1988maciejt/zabezpieczenie_samochodu_przed_kradzieza/Dokumentacja/Sposób podłączenia.pptx

Zasilanie pompy

Pompa paliwa

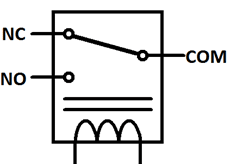
[picture p1: figure]

12V po stacyjce

Przycisk / czujnik dotykowy

Zabezpieczenie

Przekaźnik 12V
