1988maciejt/zabezpieczenie_samochodu_przed_kradzieza/Dokumentacja/Konfiguracja.docx

## Zabezpieczenie samochodu przed kradzieżą – konfiguracja

Wejście w tryb konfiguracji odbywa się następująco:

1. Włączyć zapłon.
2. Wcisnąć i trzymać przycisk odblokowania po upływie 1 sekundy, a przed upływem 2 sekund od włączenia zapłonu.
3. Usłyszymy przeciągły pisk brzęczyka (3 sekundy, ciągły).
4. Od tego momentu co 2 sekundy brzęczyk będzie generował serie odpowiednio 1, 2 lub 3 piknięć. Ka\zda seria odpowiada jednemu z trzech trybów pracy zabezpieczenia. Wybór odpowiedniego trybu dokonywany jest poprzez puszczenie przycisku zaraz po (lub w trakcie) wybrzmieniu odpowiedniej serii piknięć.

Tryby pracy:

1 – praca normalna (zabezpieczenie aktywne)

2 – zabezpieczenie nieaktywne, pompa zawsze uruchomiona (tryb odpowiedni podczas np. odstawienia samochodu do mechanika)

3 – zabezpieczenie nieaktywne, pompa zawsze wyłączona.
