1988maciejt/zabezpieczenie_samochodu_przed_kradzieza/Dokumentacja/Schemat.pdf

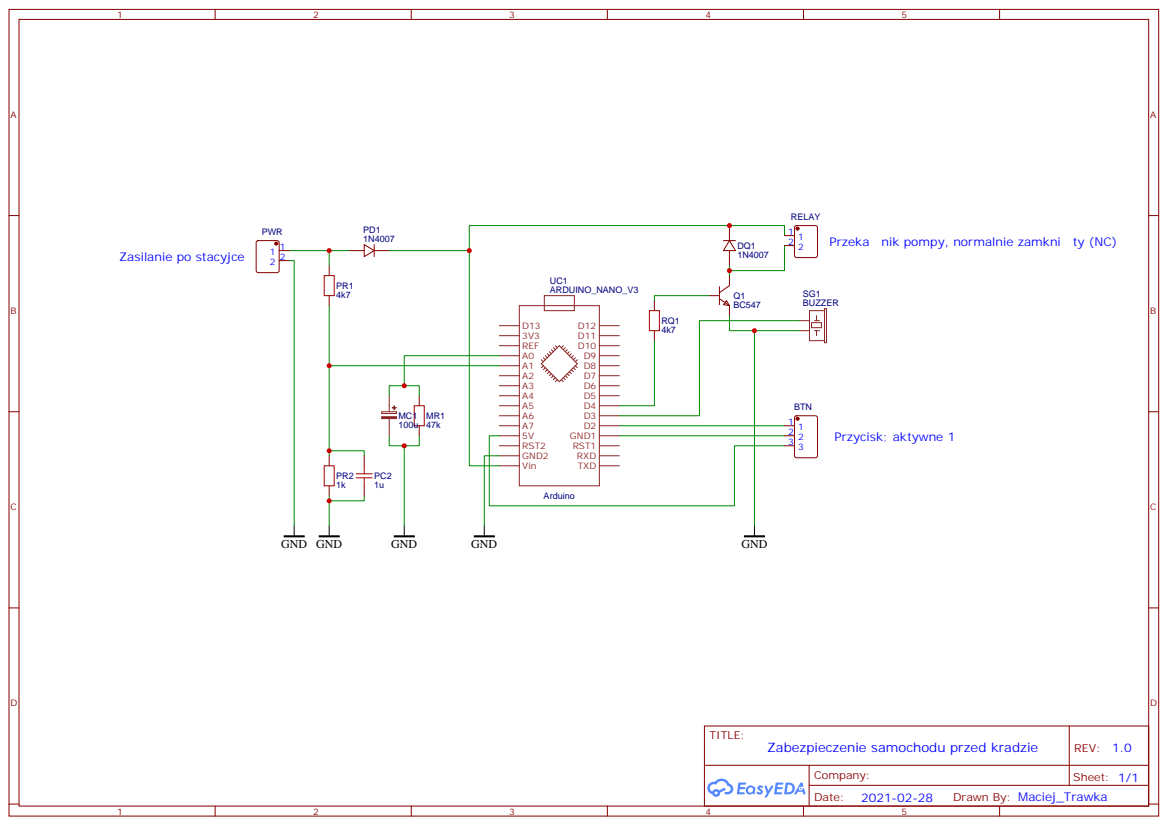
[picture p2: page 1]
