1988maciejt/zabezpieczenie_samochodu_przed_kradzieza/Dokumentacja/Algorytm_działania.pdf

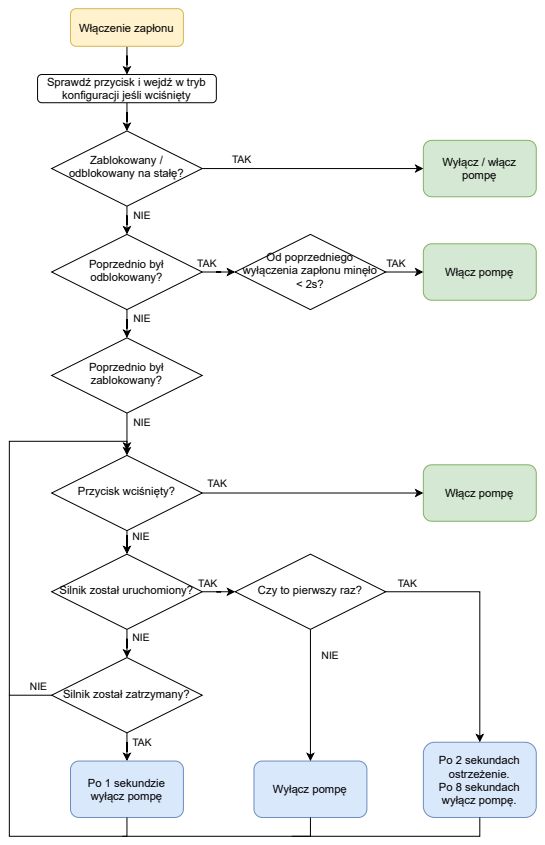
[picture p3: page 1]
Włączenie zapłonu; NIE; Poprzednio był; TAK; odblokowany?; Poprzednio był zablokowany?; Wyłącz / włącz pompę; Włącz pompę; Przycisk wciśnięty?; Wyłącz pompę; Po 2 sekundach ostrzeżenie. Po 8 sekundach wyłącz pompę.; Po 1 sekundzie wyłącz pompę

Sprawdź przycisk i wejdź w tryb
konfiguracji jeśli wciśnięty

Zablokowany /
odblokowany na stałę?

TAK Od poprzedniego
wyłączenia zapłonu minęło

TAK Silnik został uruchomiony?

Czy to pierwszy raz?

NIE
Silnik został zatrzymany?
