1988maciejt/zabezpieczenie_samochodu_przed_kradzieza/PCB/grawer/PCB_PCB_Zabezpieczenie_samochodowe_2021-03-05.pdf

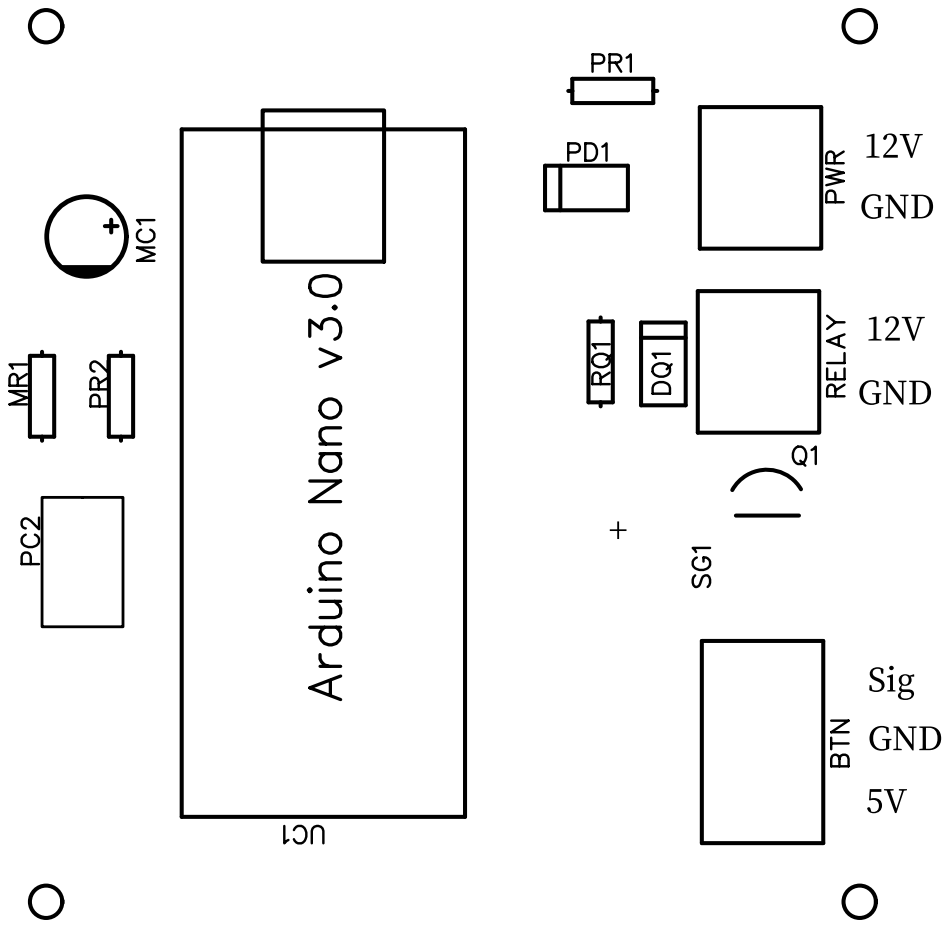
[picture p4: page 1]
